Jacob12138xieyuan/nodemcu-love-clock/docs/social.png

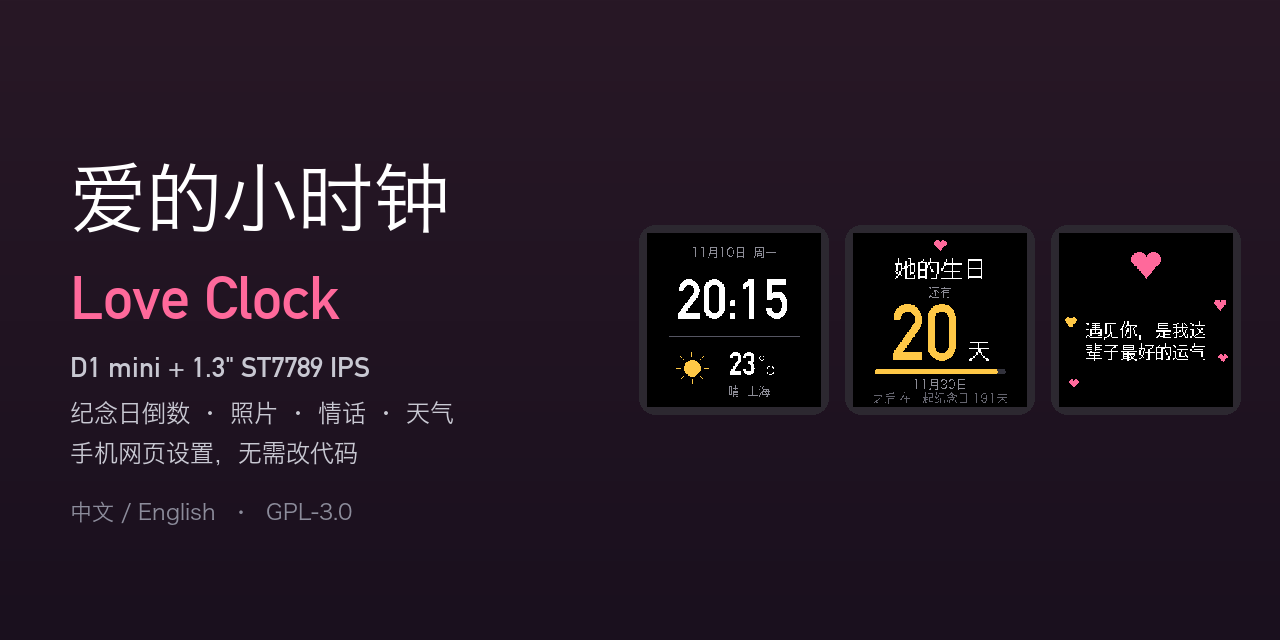
docs/social.png
