Jacob12138xieyuan/nodemcu-love-clock/stl/Body2.stl

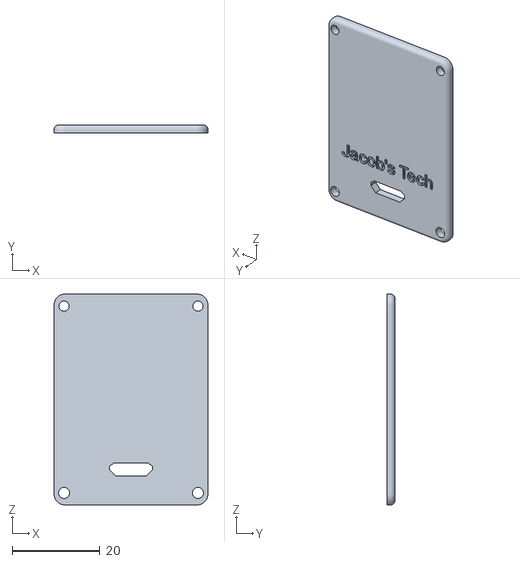
[picture p10: CAD file, 2026-11-10]
stl/Body2.stl
35.0 x 1.80 x 48.0
