Jacob12138xieyuan/nodemcu-love-clock/stl/Body1.stl

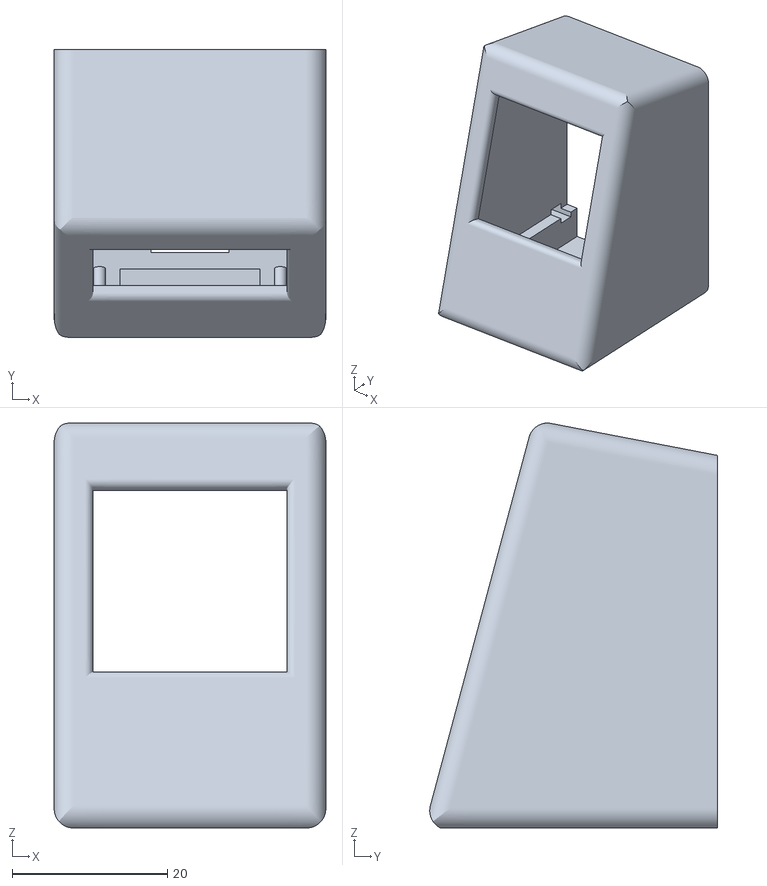
[picture p11: CAD file, 2026-11-10]
stl/Body1.stl
35.0 x 37.0 x 52.2
