Jacob12138xieyuan/nodemcu-love-clock/(commit log)

2026-11-10 README: link 3D-printed enclosure on Thingiverse
2026-11-10 Add 3D-printed enclosure STL files, preview render and README section
    [Body1.stl, Body2.stl]
2026-11-10 README: enclosure screws and print notes
2026-11-10 Add photo of the printed enclosure
2026-11-10 README: show the device photo at the top
2026-11-10 README: shrink device photo, drop caption
2026-11-11 docs: show the full D1 mini board
2026-11-11 Describe the hardware as D1 mini; update wiring diagram and social image
2026-11-11 wiring: shorten notes to fit the box
2026-11-11 wiring: draw the diagram on real board and screen photos
2026-11-11 wiring: align wire ends with the screen header pins
